ghostintranslation/motherboard6/(commit log)

2020-06-20 Leds and analog - Improved leds - Improved analog read
2020-06-20 Updated schematics
2020-07-03 - Used bool for buttons and switches - Added print function for LEDs - Updated init sequence - Improved potentiometers reading
2020-07-18 Singleton and Improved encoders
    - Made Motherboard6 a singleton
    - Fixed wrong type of encoders variable
    - Fixed issue with LED interfering encoders readings
    [Motherboard6.h, Motherboard6.ino]
2020-07-19 Fixed MIDI channel
    Fixed Motherboard6 MIDI channel reading
    [Motherboard6.h]
2020-07-20 Fixed missing variable initialization causing Teensy to crash and code not uploading on latest Teensyduino
    [Motherboard6.h]
2020-07-21 Fixed missing variable initialization causing memory issue
    [Motherboard6.h]
2020-07-24 Added callbacks
    - Added Press, Long Press, Change callbacks
    - Renamed Display to LED
    - Added method to set all leds by a binary representation of a number
    - Added method to toggle one led
2020-08-23 Added possibility to dim the leds
